Yahalloo/TL73_Helmholtz_Cage/TL_73_Helmholtz_Cage_PCB.csv

Reference | Value | Datasheet | Footprint | Qty | DNP | LCSC Part
C1,C56,C57,C58,C65,C67,C68,C69,C70,C71,C72,C73,C74,C83,C85,C86,C87,C88,C89,C90,C91,C92,C101,C103,C104,C105,C106,C107,C108,C109,C110 | 100nF |  | Capacitor_SMD:C_1206_3216Metric_Pad1.33x1.80mm_HandSolder | 31
C59,C62,C63,C64,C66,C77,C80,C81,C82,C84,C95,C98,C99,C100,C102 | 1uF |  | Capacitor_SMD:C_0805_2012Metric_Pad1.18x1.45mm_HandSolder | 15
C60,C78,C96 | 300uF |  |  | 3
C61,C79,C97 | 47uF |  | Capacitor_SMD:C_0805_2012Metric_Pad1.18x1.45mm_HandSolder | 3
C75,C93,C111 | 10 nF |  | Capacitor_SMD:C_0805_2012Metric_Pad1.18x1.45mm_HandSolder | 3
C76,C94,C112 | 1000uF |  | Capacitor_THT:CP_Radial_D12.5mm_P5.00mm | 3
H1,H2,H3 | MountingHole |  | MountingHole:MountingHole_3.2mm_M3 | 3
J1 | CN7 |  | Connector_PinSocket_2.54mm:PinSocket_2x19_P2.54mm_Vertical | 1
J2 | CN10 |  | Connector_PinSocket_2.54mm:PinSocket_2x19_P2.54mm_Vertical | 1
L13,L14,L15,L16,L17,L18,L19,L20,L21,L22,L23,L24 | 30Ω@100MHz |  | Capacitor_SMD:C_0805_2012Metric_Pad1.18x1.45mm_HandSolder | 12
R1,R2,R3 | WSK2512R0100FEA | https://www.lcsc.com/datasheet/C3985410.pdf | EasyEDA:RES-SMD_L6.4-W3.2_WSK2512R0100FEA | 3 |  | C3985410
R22,R24,R28,R30,R34,R36 | 10k |  | Capacitor_SMD:C_0805_2012Metric_Pad1.18x1.45mm_HandSolder | 6 | DNP
R23,R29,R35 | 10k |  | Capacitor_SMD:C_0805_2012Metric_Pad1.18x1.45mm_HandSolder | 3
R25,R31,R37 | 1 |  | Capacitor_SMD:C_0805_2012Metric_Pad1.18x1.45mm_HandSolder | 3
R26,R32,R38 | 36k |  | Capacitor_SMD:C_0805_2012Metric_Pad1.18x1.45mm_HandSolder | 3
R27,R33,R39 | 3.3 |  | Capacitor_SMD:C_0805_2012Metric_Pad1.18x1.45mm_HandSolder | 3
U1,U2,U3 | INA240A1D | http://www.ti.com/lit/ds/symlink/ina240.pdf | Package_SO:SOIC-8_3.9x4.9mm_P1.27mm | 3
U7,U8,U9 | DRV8412 | https://www.ti.com/lit/gpn/DRV8412 | Package_SO:HTSSOP-44-1EP_6.1x14mm_P0.635mm_EP5.2x14mm_Mask4.31x8.26mm_ThermalVias | 3
