Yahalloo/TL73_Helmholtz_Cage/TL_73_Helmholtz_Cage_PCB.kicad_pcb

## KiCad design TL_73_Helmholtz_Cage_PCB.kicad_pcb (2026-11-14)

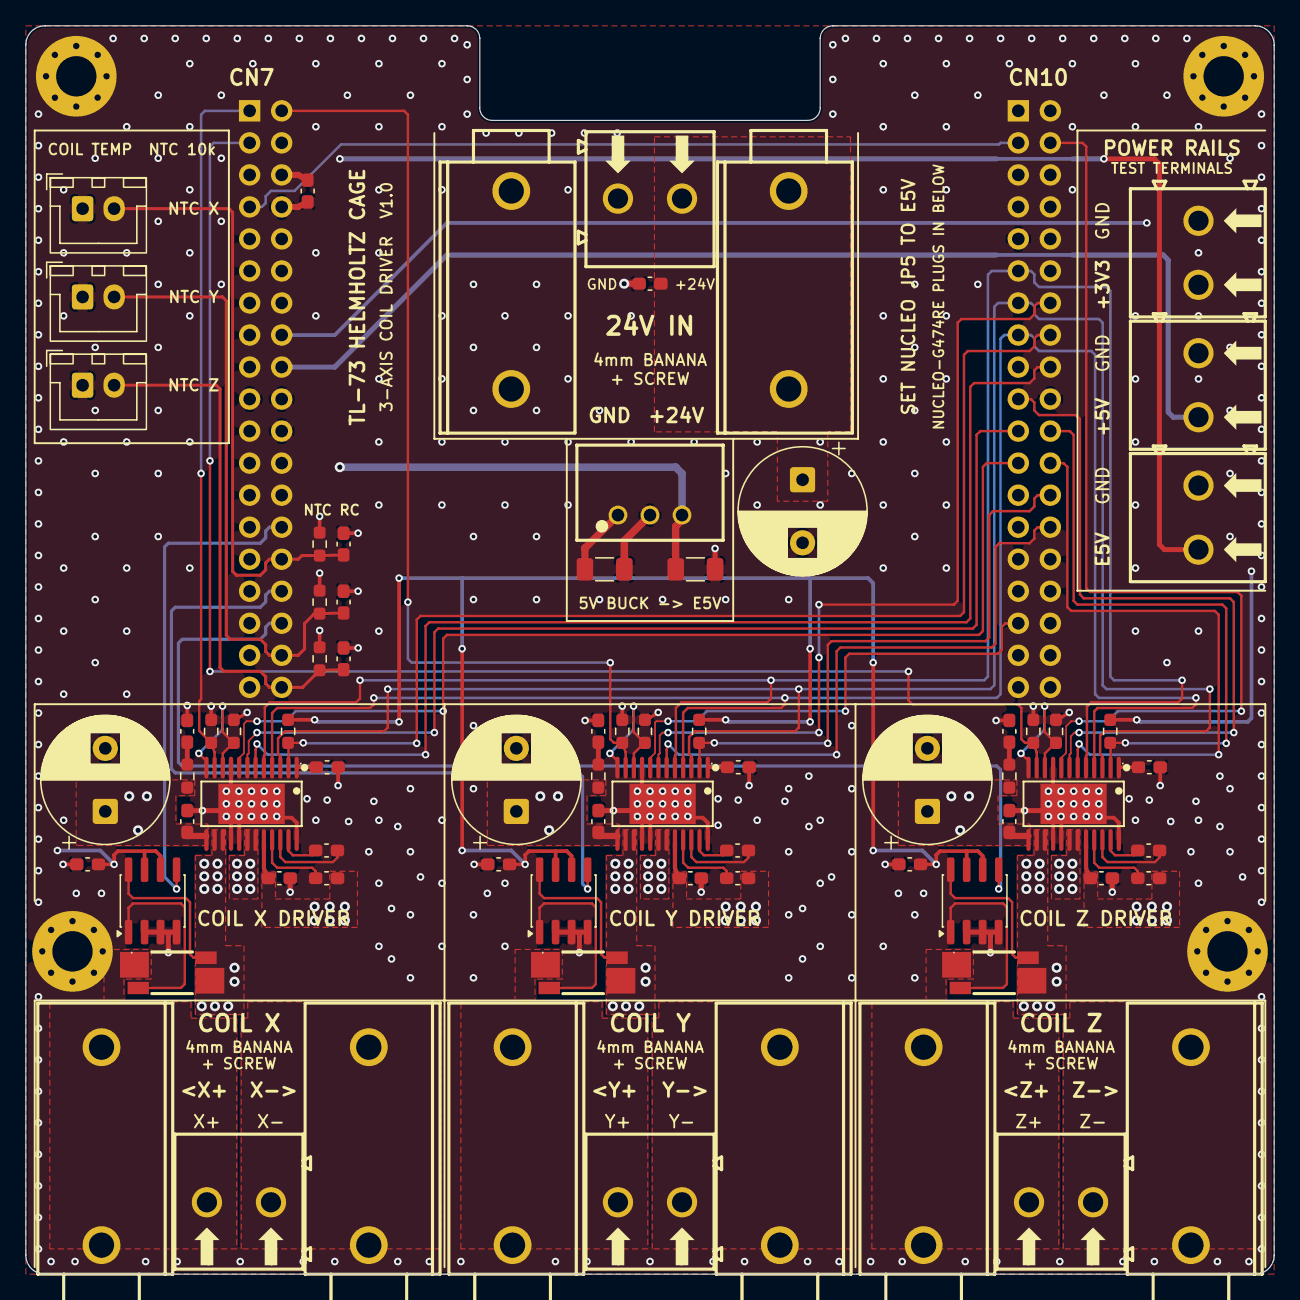
[picture p1: board TL_73_Helmholtz_Cage_PCB.kicad_pcb from above]

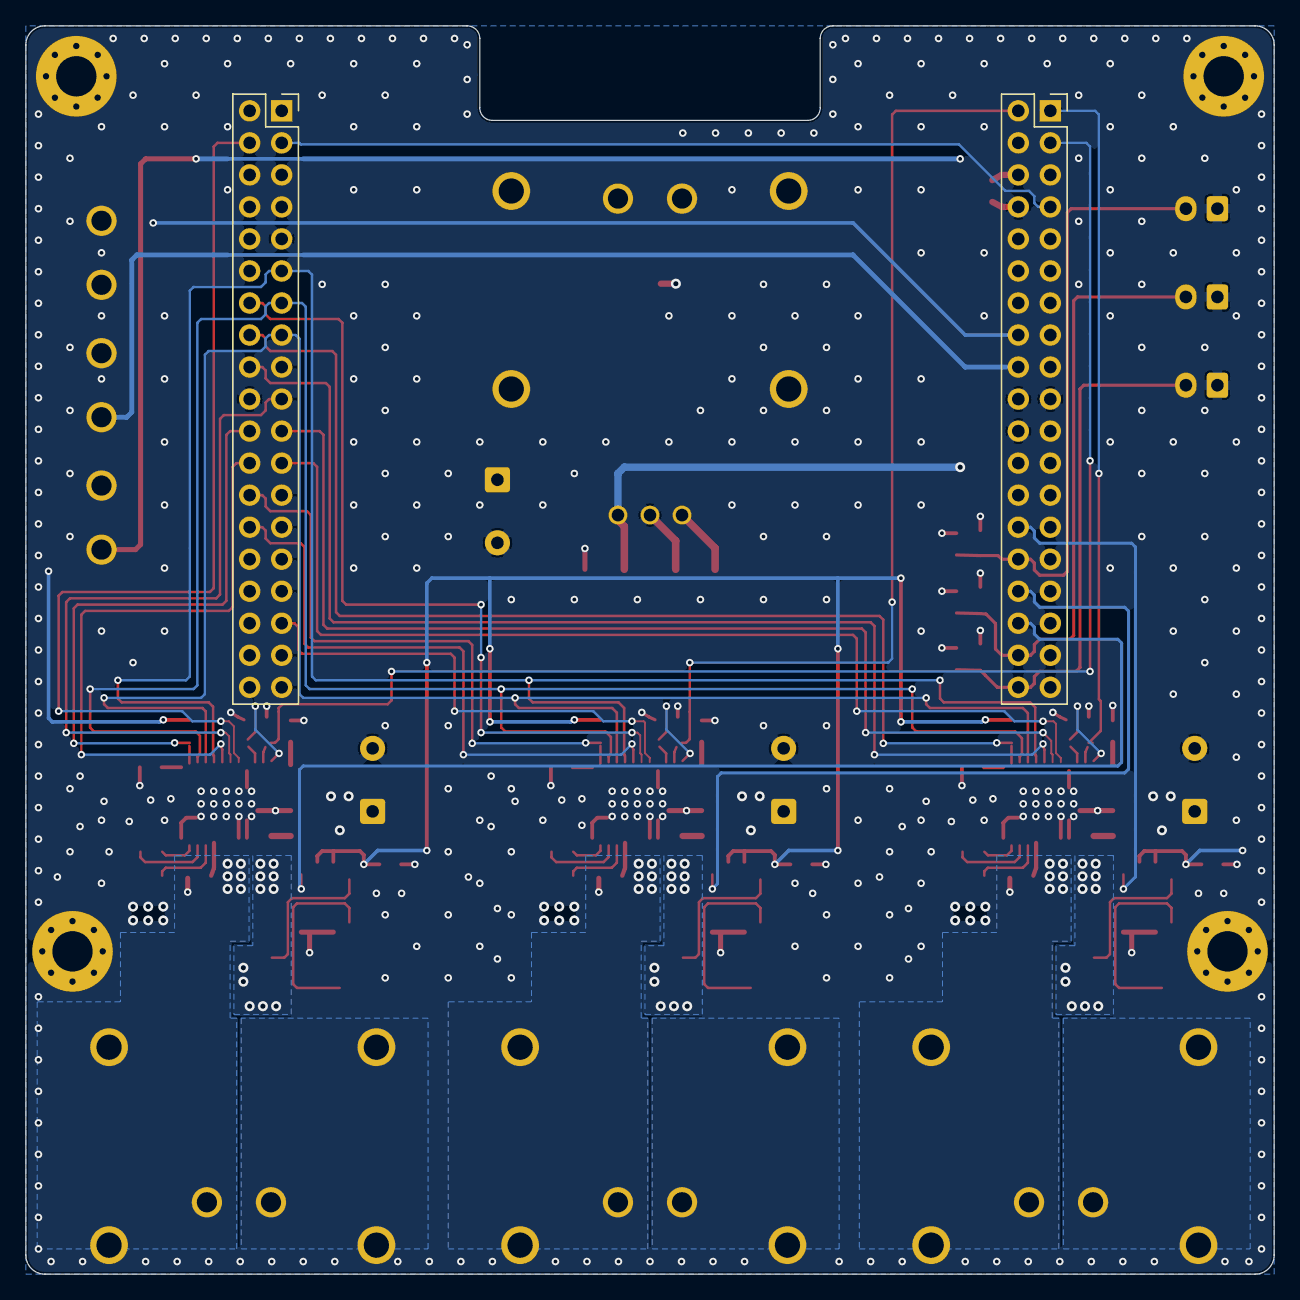
[picture p2: board TL_73_Helmholtz_Cage_PCB.kicad_pcb from below]

Board: 4 copper layers, 99.0 x 99.0 mm, 81 parts (2 on the bottom side), 63 nets.

Parts:
C101: 10uF; C_1206_3216Metric_Pad1.33x1.80mm_HandSolder
C102: 22uF; C_1206_3216Metric_Pad1.33x1.80mm_HandSolder
C201, C302, C305, C402, C405, C502, C505, C601, C701, C801, C901, C1001, C1101, C1202: 100nF; C_0603_1608Metric_Pad1.08x0.95mm_HandSolder
C301, C304, C401, C404, C501, C504: 1uF; C_0603_1608Metric_Pad1.08x0.95mm_HandSolder
C303, C403, C503: 47nF; C_0603_1608Metric_Pad1.08x0.95mm_HandSolder
C306, C406, C506: 10nF; C_0603_1608Metric_Pad1.08x0.95mm_HandSolder
C307, C407, C507, C1201: 1000uF; CP_Radial_D10.0mm_P5.00mm
CN1201: 24.243.1; CONN-TH_24.243.1_RED
CN1202: 24.243.2; CONN-TH_24.243.2
CN1203, CN1205, CN1207: 24.243.3; CONN-TH_24.243.3
CN1204, CN1206, CN1208: 24.243.5; CONN-TH_24.243.2
H101, H102, H103, H104: MountingHole; MountingHole_3.2mm_M3_Pad_Via
J201: CN7; PinSocket_2x19_P2.54mm_Vertical
J202: CN10; PinSocket_2x19_P2.54mm_Vertical
J901, J1001, J1101: NTC_JST_XH; JST_XH_B2B-XH-A_1x02_P2.50mm_Vertical
R301, R302, R401, R402, R501, R502, R901, R1001, R1101: 10k; R_0603_1608Metric_Pad0.98x0.95mm_HandSolder
R303, R403, R503: 470Ω; R_0603_1608Metric_Pad0.98x0.95mm_HandSolder
R304, R404, R504: 3.3Ω; R_0603_1608Metric_Pad0.98x0.95mm_HandSolder
R601, R701, R801: 10mΩ; RES-SMD_L6.4-W3.2_WSK2512R0100FEA
U101: K7805-1000R3_C2992391; PWRM-TH_YLPTEC_K78XX-1000R3
U301, U401, U501: DRV8873SPWPR; HTSSOP-24_L7.8-W4.4-P0.65-LS6.4-TL-EP
U601, U701, U801: INA240A1D; SOIC-8_3.9x4.9mm_P1.27mm
U1201, U1202, U1203, U1204, U1205, U1206, U1207: KF128-5.08-2P; CONN-TH_P5.08_KF128-5.08-2P

Connections:
+3V3: C601.1, C701.1, C801.1, J201.16, R301.1, R401.1, R501.1, R901.2, R1001.2, R1101.2, U601.6 (V+), U601.7 (REF1), U701.6 (V+), U701.7 (REF1), U801.6 (V+), U801.7 (REF1), U1207.1
+5V: J201.18, U1205.1
+24V: C101.1, C302.1, C304.1, C305.1, C307.1, C402.1, C404.1, C405.1, C407.1, C502.1, C504.1, C505.1, C507.1, C1201.1, C1202.1, CN1201.1, CN1201.2, R304.1, R404.1, R504.1, U101.1 (VIN), U301.13 (13VM), U301.20 (20VM), U401.13 (13VM), U401.20 (20VM), U501.13 (13VM), U501.20 (20VM), U1202.1
/CurrentSense_CoilX/Icoil1: R601.4 (I1), U301.14 (14OUT2), U301.15 (15OUT2)
/CurrentSense_CoilX/Icoil2: CN1203.1, CN1203.2, R601.1 (I2), U1201.1
/CurrentSense_CoilX/SENSE_N: R601.2 (E2), U601.1 (-)
/CurrentSense_CoilX/SENSE_P: R601.3 (E1), U601.8 (+)
/CurrentSense_CoilY/Icoil1: R701.4 (I1), U401.14 (14OUT2), U401.15 (15OUT2)
/CurrentSense_CoilY/Icoil2: CN1205.1, CN1205.2, R701.1 (I2), U1203.1
/CurrentSense_CoilY/SENSE_N: R701.2 (E2), U701.1 (-)
/CurrentSense_CoilY/SENSE_P: R701.3 (E1), U701.8 (+)
/CurrentSense_CoilZ/Icoil1: R801.4 (I1), U501.14 (14OUT2), U501.15 (15OUT2)
/CurrentSense_CoilZ/Icoil2: CN1207.1, CN1207.2, R801.1 (I2), U1206.1
/CurrentSense_CoilZ/SENSE_N: R801.2 (E2), U801.1 (-)
/CurrentSense_CoilZ/SENSE_P: R801.3 (E1), U801.8 (+)
/External_Connectors/CoilX-: CN1204.1, CN1204.2, U301.18 (18OUT1), U301.19 (19OUT1), U1201.2
/External_Connectors/CoilY-: CN1206.1, CN1206.2, U401.18 (18OUT1), U401.19 (19OUT1), U1203.2
/External_Connectors/CoilZ-: CN1208.1, CN1208.2, U501.18 (18OUT1), U501.19 (19OUT1), U1206.2
/ISENSE_CoilX: J201.28, U601.5
/ISENSE_CoilY: J201.32, U701.5
/ISENSE_CoilZ: J201.34, U801.5
/Nucleo_G474RE/PB8-BOOT0: J201.7, J202.3
/PWM_A_CoilX: J202.23, U301.8 (8PH/IN2)
/PWM_A_CoilY: J202.33, U401.8 (8PH/IN2)
/PWM_A_CoilZ: J202.4, U501.8 (8PH/IN2)
/PWM_B_CoilX: J202.21, U301.7 (7EN/IN1)
/PWM_B_CoilY: J202.14, U401.7 (7EN/IN1)
/PWM_B_CoilZ: J202.19, U501.7 (7EN/IN1)
/SPI_SCLK: J202.11, U301.5 (5SCLK), U401.5 (5SCLK), U501.5 (5SCLK)
/SPI_SDI: J202.15, U301.4 (4SDI), U401.4 (4SDI), U501.4 (4SDI)
/SPI_SDO: J202.13, U301.3 (3SDO), U401.3 (3SDO), U501.3 (3SDO)
/Temp_SenseX: C901.1, J201.30, J901.2, R901.1
/Temp_SenseY: C1001.1, J201.36, J1001.2, R1001.1
/Temp_SenseZ: C1101.1, J201.38, J1101.2, R1101.1
/~FAULT_CoilX: J202.16, R301.2, U301.2 (2nFAULT)
/~FAULT_CoilY: J202.26, R401.2, U401.2 (2nFAULT)
/~FAULT_CoilZ: J202.22, R501.2, U501.2 (2nFAULT)
/~SCS_CoilX: J202.18, U301.6 (6nSCS)
/~SCS_CoilY: J202.28, U401.6 (6nSCS)
/~SCS_CoilZ: J202.24, U501.6 (6nSCS)
/~SLEEP_CoilX: J201.1, R302.1, U301.11 (11NSLEEP)
/~SLEEP_CoilY: J201.2, R402.1, U401.11 (11NSLEEP)
/~SLEEP_CoilZ: J201.3, R502.1, U501.11 (11NSLEEP)
E5V: C102.1, C201.1, J201.6, U101.3 (+VO), U1204.1
GND: C101.2, C102.2, C201.2, C301.2, C302.2, C305.2, C306.2, C307.2, C401.2, C402.2, C405.2, C406.2, C407.2, C501.2, C502.2, C505.2, C506.2, C507.2, C601.2, C701.2, C801.2, C901.2, C1001.2, C1101.2, C1201.2, C1202.2, CN1202.1, CN1202.2, J201.8, J201.19, J201.20, J201.22, J202.9, J202.20, J901.1, J1001.1, J1101.1, R302.2, R303.2, R402.2, R403.2, R502.2, R503.2, U101.2 (GND), U301.9 (9DISABLE), U301.16 (16SRC), U301.17 (17SRC), U301.24 (24GND), U301.25 (EP), U401.9 (9DISABLE), U401.16 (16SRC), U401.17 (17SRC), U401.24 (24GND), U401.25 (EP), U501.9 (9DISABLE), U501.16 (16SRC), U501.17 (17SRC), U501.24 (24GND), U501.25 (EP), U601.2 (GND), U601.3 (REF2), U601.4 (GND), U701.2 (GND), U701.3 (REF2), U701.4 (GND), U801.2 (GND), U801.3 (REF2), U801.4 (GND), U1202.2, U1204.2, U1205.2, U1207.2
unnamed: C306.1, R304.2
unnamed: C406.1, R404.2
unnamed: C506.1, R504.2
unnamed: C301.1, U301.1 (1DVDD)
unnamed: R303.1, U301.10 (10IPROPL), U301.12 (12IPROPI2)
unnamed: C304.2, U301.21 (21VCP)
unnamed: C303.2, U301.22 (22CPH)
unnamed: C303.1, U301.23 (23CPL)
unnamed: C401.1, U401.1 (1DVDD)
unnamed: R403.1, U401.10 (10IPROPL), U401.12 (12IPROPI2)
unnamed: C404.2, U401.21 (21VCP)
unnamed: C403.2, U401.22 (22CPH)
unnamed: C403.1, U401.23 (23CPL)
unnamed: C501.1, U501.1 (1DVDD)
unnamed: R503.1, U501.10 (10IPROPL), U501.12 (12IPROPI2)
unnamed: C504.2, U501.21 (21VCP)
unnamed: C503.2, U501.22 (22CPH)
unnamed: C503.1, U501.23 (23CPL)
