Yahalloo/TL73_Helmholtz_Cage/_restore_backup_2026-11-02T14-09-26-094/TL_73_Helmholtz_Cage_PCB.kicad_pcb

## KiCad design _restore_backup_2026-11-02T14-09-26-094/TL_73_Helmholtz_Cage_PCB.kicad_pcb (2026-11-03)

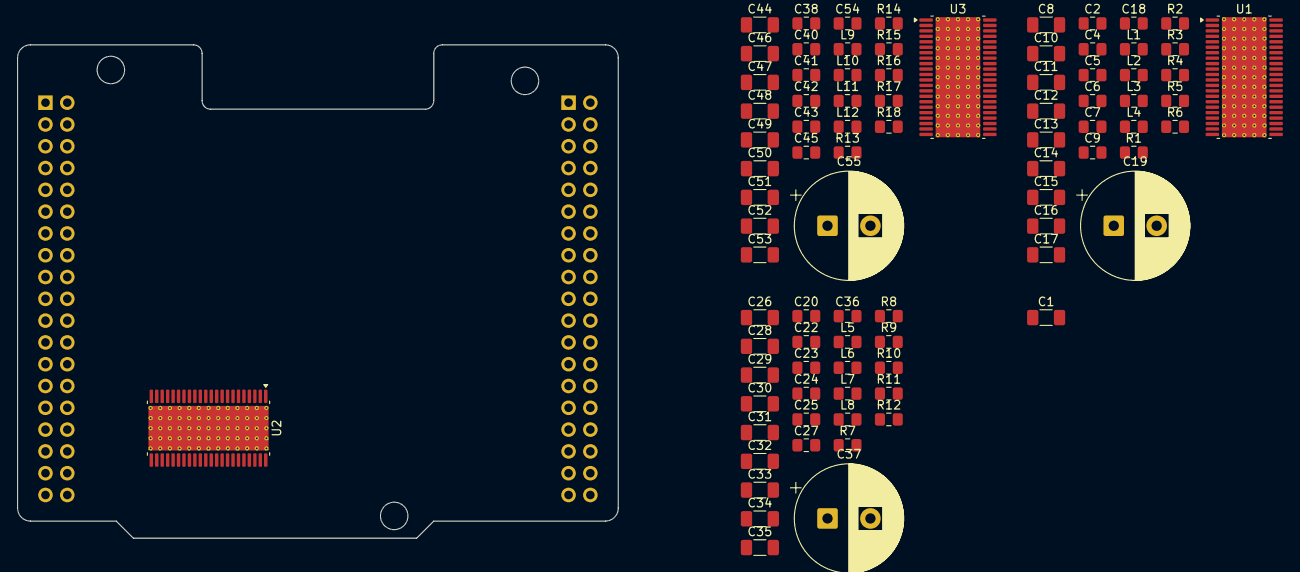
[picture p3: board _restore_backup_2026-11-02T14-09-26-094/TL_73_Helmholtz_Cage_PCB.kica… from above]

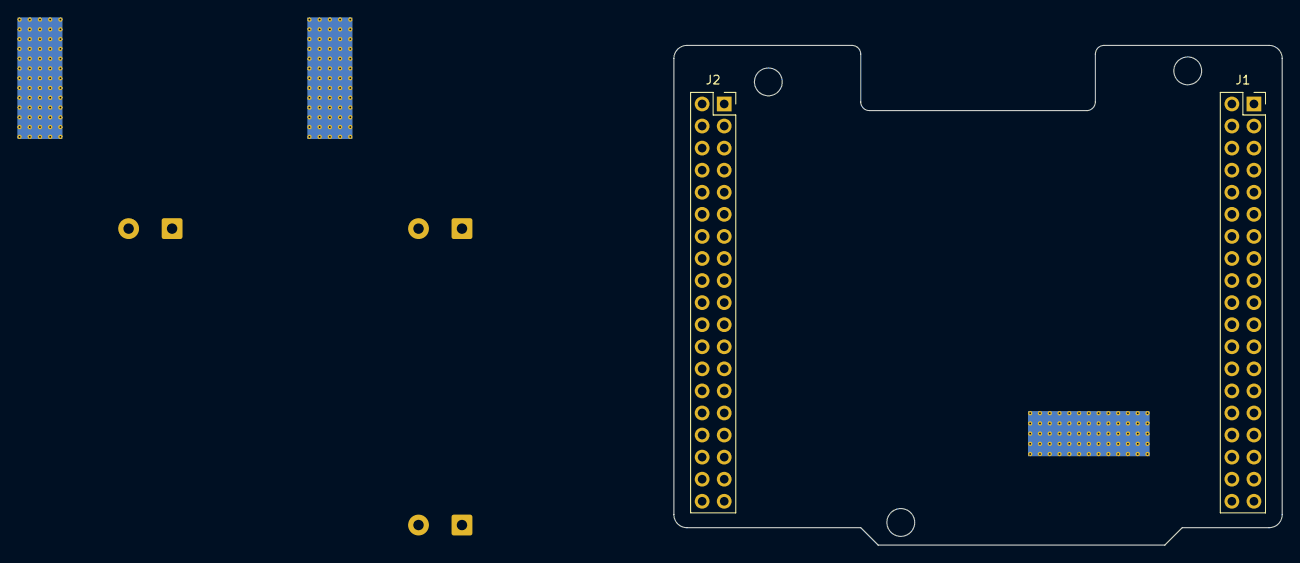
[picture p4: board _restore_backup_2026-11-02T14-09-26-094/TL_73_Helmholtz_Cage_PCB.kica… from below]

Board: 2 copper layers, 70.0 x 57.5 mm, 90 parts (2 on the bottom side), 64 nets, no tracks yet.

Parts:
C1, C8, C10, C11, C12, C13, C14, C15, C16, C17, C26, C28, C29, C30, C31, C32, C33, C34, C35, C44, C46, C47, C48, C49, C50, C51, C52, C53: 100nF; C_1206_3216Metric_Pad1.33x1.80mm_HandSolder
C2, C5, C6, C7, C9, C20, C23, C24, C25, C27, C38, C41, C42, C43, C45: 1uF; C_0805_2012Metric_Pad1.18x1.45mm_HandSolder
C4, C22, C40: 47uF; C_0805_2012Metric_Pad1.18x1.45mm_HandSolder
C18, C36, C54: 10 nF; C_0805_2012Metric_Pad1.18x1.45mm_HandSolder
C19, C37, C55: 1000uF; CP_Radial_D12.5mm_P5.00mm
H1, H2, H3: MountingHole; MountingHole_3.2mm_M3
J1: CN7; PinSocket_2x19_P2.54mm_Vertical
J2: CN10; PinSocket_2x19_P2.54mm_Vertical
L1, L2, L3, L4, L5, L6, L7, L8, L9, L10, L11, L12: 30Ω@100MHz; C_0805_2012Metric_Pad1.18x1.45mm_HandSolder
R1, R2, R3, R7, R8, R9, R13, R14, R15: 10k; C_0805_2012Metric_Pad1.18x1.45mm_HandSolder
R4, R10, R16: 1; C_0805_2012Metric_Pad1.18x1.45mm_HandSolder
R5, R11, R17: 36k; C_0805_2012Metric_Pad1.18x1.45mm_HandSolder
R6, R12, R18: 3.3; C_0805_2012Metric_Pad1.18x1.45mm_HandSolder
U1, U2, U3: DRV8412; HTSSOP-44-1EP_6.1x14mm_P0.635mm_EP5.2x14mm_Mask4.31x8.26mm_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

Connections:
+3V3: J1.16, R1.1, R3.1, R7.1, R9.1, R13.1, R15.1
+12V: C1.1, J1.24
+24V: C10.2, C11.2, C12.2, C17.2, C19.1, C28.2, C29.2, C30.2, C35.2, C37.1, C46.2, C47.2, C48.2, C53.2, C55.1, R6.1, R12.1, R18.1, U1.26 (PVDD_A), U1.27 (PVDD_A), U1.32 (PVDD_B), U1.35 (PVDD_C), U1.40 (PVDD_D), U1.41 (PVDD_D), U2.26 (PVDD_A), U2.27 (PVDD_A), U2.32 (PVDD_B), U2.35 (PVDD_C), U2.40 (PVDD_D), U2.41 (PVDD_D), U3.26 (PVDD_A), U3.27 (PVDD_A), U3.32 (PVDD_B), U3.35 (PVDD_C), U3.40 (PVDD_D), U3.41 (PVDD_D)
/Current_Driver_Distribution/VOUTA_CoilX: L1.2, L2.2
/Current_Driver_Distribution/VOUTA_CoilY: L5.2, L6.2
/Current_Driver_Distribution/VOUTA_CoilZ: L9.2, L10.2
/Current_Driver_Distribution/VOUTB_CoilX: L3.2, L4.2
/Current_Driver_Distribution/VOUTB_CoilY: L7.2, L8.2
/Current_Driver_Distribution/VOUTB_CoilZ: L11.2, L12.2
/PWM_A_CoilX: J2.23, U1.17 (PWM_A)
/PWM_A_CoilY: J2.33, U2.17 (PWM_A)
/PWM_A_CoilZ: J2.4, U3.17 (PWM_A)
/PWM_B_CoilX: J2.21, U1.15 (PWM_B)
/PWM_B_CoilY: J2.14, U2.15 (PWM_B)
/PWM_B_CoilZ: J2.19, U3.15 (PWM_B)
/~FAULT_CoilX: J2.16, R3.2, U1.18 (~FAULT)
/~FAULT_CoilY: J2.26, R9.2, U2.18 (~FAULT)
/~FAULT_CoilZ: J2.22, R15.2, U3.18 (~FAULT)
/~OTW_CoilX: J2.18, R1.2, U1.21 (~OTW)
/~OTW_CoilY: J2.28, R7.2, U2.21 (~OTW)
/~OTW_CoilZ: J2.24, R13.2, U3.21 (~OTW)
/~RESET_CoilX: J1.1, R2.1, U1.6 (~RESET_CD), U1.16 (~RESET_AB)
/~RESET_CoilY: J1.2, R8.1, U2.6 (~RESET_CD), U2.16 (~RESET_AB)
/~RESET_CoilZ: J1.3, R14.1, U3.6 (~RESET_CD), U3.16 (~RESET_AB)
GND: C1.2, C2.1, C4.2, C5.1, C6.1, C7.2, C9.1, C10.1, C11.1, C12.1, C17.1, C18.2, C19.2, C20.1, C22.2, C23.1, C24.1, C25.2, C27.1, C28.1, C29.1, C30.1, C35.1, C36.2, C37.2, C38.1, C40.2, C41.1, C42.1, C43.2, C45.1, C46.1, C47.1, C48.1, C53.1, C54.2, C55.2, J1.8, J1.19, J1.20, J1.22, J2.20, R2.2, R4.2, R8.2, R10.2, R14.2, R16.2, U1.3 (NC/GND), U1.4 (NC/GND), U1.5 (PWM_D), U1.7 (PWM_C), U1.13 (GND), U1.19 (NC/GND), U1.20 (NC/GND), U1.25 (NC/GND), U1.29 (GND_A), U1.30 (GND_B), U1.37 (GND_C), U1.38 (GND_D), U1.42 (NC/GND), U1.45 (EP), U2.3 (NC/GND), U2.4 (NC/GND), U2.5 (PWM_D), U2.7 (PWM_C), U2.13 (GND), U2.19 (NC/GND), U2.20 (NC/GND), U2.25 (NC/GND), U2.29 (GND_A), U2.30 (GND_B), U2.37 (GND_C), U2.38 (GND_D), U2.42 (NC/GND), U2.45 (EP), U3.3 (NC/GND), U3.4 (NC/GND), U3.5 (PWM_D), U3.7 (PWM_C), U3.13 (GND), U3.19 (NC/GND), U3.20 (NC/GND), U3.25 (NC/GND), U3.29 (GND_A), U3.30 (GND_B), U3.37 (GND_C), U3.38 (GND_D), U3.42 (NC/GND), U3.45 (EP)
unnamed: C18.1, R6.2
unnamed: C36.1, R12.2
unnamed: C54.1, R18.2
unnamed: C2.2, C4.1, C5.2, C6.2, C7.1, C9.2, U1.1 (GVDD_C), U1.2 (VDD), U1.22 (GVDD_B), U1.23 (GVDD_A), U1.44 (GVDD_D)
unnamed: C20.2, C22.1, C23.2, C24.2, C25.1, C27.2, U2.1 (GVDD_C), U2.2 (VDD), U2.22 (GVDD_B), U2.23 (GVDD_A), U2.44 (GVDD_D)
unnamed: C38.2, C40.1, C41.2, C42.2, C43.1, C45.2, U3.1 (GVDD_C), U3.2 (VDD), U3.22 (GVDD_B), U3.23 (GVDD_A), U3.44 (GVDD_D)
unnamed: C8.1, R4.1, R5.1, U1.8 (M1), U1.10 (M3), U1.12 (AGND)
unnamed: C13.1, U1.24 (BST_A)
unnamed: C14.1, U1.33 (BST_B)
unnamed: C15.1, U1.34 (BST_C)
unnamed: C16.1, U1.43 (BST_D)
unnamed: C8.2, U1.9 (M2), U1.11 (VREG)
unnamed: R5.2, U1.14 (OC_ADJ)
unnamed: C13.2, L1.1, U1.28 (OUT_A)
unnamed: C14.2, L2.1, U1.31 (OUT_B)
unnamed: C15.2, L3.1, U1.36 (OUT_C)
unnamed: C16.2, L4.1, U1.39 (OUT_D)
unnamed: C26.1, R10.1, R11.1, U2.8 (M1), U2.10 (M3), U2.12 (AGND)
unnamed: C31.1, U2.24 (BST_A)
unnamed: C32.1, U2.33 (BST_B)
unnamed: C33.1, U2.34 (BST_C)
unnamed: C34.1, U2.43 (BST_D)
unnamed: C26.2, U2.9 (M2), U2.11 (VREG)
unnamed: R11.2, U2.14 (OC_ADJ)
unnamed: C31.2, L5.1, U2.28 (OUT_A)
unnamed: C32.2, L6.1, U2.31 (OUT_B)
unnamed: C33.2, L7.1, U2.36 (OUT_C)
unnamed: C34.2, L8.1, U2.39 (OUT_D)
unnamed: C44.1, R16.1, R17.1, U3.8 (M1), U3.10 (M3), U3.12 (AGND)
unnamed: C49.1, U3.24 (BST_A)
unnamed: C50.1, U3.33 (BST_B)
unnamed: C51.1, U3.34 (BST_C)
unnamed: C52.1, U3.43 (BST_D)
unnamed: C44.2, U3.9 (M2), U3.11 (VREG)
unnamed: R17.2, U3.14 (OC_ADJ)
unnamed: C49.2, L9.1, U3.28 (OUT_A)
unnamed: C50.2, L10.1, U3.31 (OUT_B)
unnamed: C51.2, L11.1, U3.36 (OUT_C)
unnamed: C52.2, L12.1, U3.39 (OUT_D)
