Yahalloo/TL73_Helmholtz_Cage/(commit log)

2026-11-01 Initial Commit, added template for Schematic and PCB file
2026-11-01 Updated Schematics by adding DRV8412 circuit and connections to Nucleo G474, added .gitignore
2026-11-01 Updated Schematics by adding footprints to most symbols
2026-11-01 Updated Schematics by adding LCSC part numbers to most components
2026-11-03 Added current sense circuit to schematic
2026-11-03 Started fixing hierarchal blocks for adding sense circuit
2026-11-03 Added Nucleo Pins schematic,
2026-11-03 Updated Hierarchal Blocks, updated Current sense circuit with footprint for Rsense, added more notes
2026-11-04 Update PCB layout and project settings
2026-11-12 Add connectors sheet, 99x99 4-layer placement, 3-axis temp sense
    Schematic
    - External_Connectors sheet: 24 V banana input, coil X/Y/Z banana jacks with
    a screw terminal between each pair, power-rail test terminals
    - TempSense is now instantiated for X, Y and Z (PA1 / PC1 / PC0, all ADC1);
    the on-board NTC is replaced by a 2-pin JST XH header per coil
    - Footprints assigned for C60/C78/C96, JP4-6 and the temp-sense R/C
    - Teammate's temp-sense sheet and lcsc library integrated
    PCB
    - Synced from schematic, 4 copper layers with JLCPCB-style stackup
    - 99 x 99 mm outline, initial placement (no routing), identical driver
    channels with placement rule areas for Repeat Layout
    - Silkscreen labels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
2026-11-12 Add STM32 pinout table to the Nucleo sheet
    Native KiCad table listing each signal's MCU pin, morpho connector pin, direction and suggested peripheral. Pin columns are generated from the netlist.
2026-11-13 Updated schematics to add ratings to each passive component, more mouting holes, DC-DC buck module added and new PCB outline
2026-11-13 Add plated pads and stitching vias to M3 mounting holes
    Swap H1-H4 from bare NPTH holes to MountingHole_3.2mm_M3_Pad_Via
    (6.4 mm exposed pad, 3.2 mm plated drill, 8 vias) in both the board
    and the schematic footprint fields. Zones refilled.
2026-11-13 Replace DRV8412 with DRV8873S, 5 V buck, 99x99 rectangular layout
    - H-bridge sheet rebuilt around the DRV8873S (SPI variant): charge-pump,
    DVDD and VM bypass caps, nFAULT pull-up, nSLEEP pull-down, IPROPI
    monitor resistor. 12 V gate supply, bootstrap parts and ferrite beads
    removed; outputs go straight to the coil.
    - PWM_A drives IN2/OUT2 (coil +, through the shunt), PWM_B drives
    IN1/OUT1, so the power pins face the coil connectors.
    - SPI1 (PA5/PA6/PA7) shared by the three drivers, chip selects on the
    former OTW pins (PB11, PB14, PB1). RESET renamed SLEEP.
    - Buck is now a K7805-1000R3: output net E5V feeds Nucleo E5V (CN7-6),
    VIN no longer used. Pinout table and notes u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
2026-11-14 Route PCB, add 24 V input caps, In2 rail islands
    - Add C1201 (1000 uF bulk) and C1202 (100 nF) on the 24 V input;
    C1201 sits below the +24 V banana jack
    - Name shunt sense nets SENSE_P / SENSE_N (differential pair)
    - Route the whole board: GND plane on In1, +24 V plane on In2 with
    +3V3 / E5V islands where no 24 V current flows
    - Coil outputs on F.Cu + B.Cu pours stitched with vias; Kelvin sense
    pairs under each INA240; thermal vias under each DRV8873
    - GND stitching vias and a perimeter via fence
    - 45 degree corners throughout; net classes Power / Sense / LogicPwr
